ara-mkr/f405-flight-controller/README.md

# F405 Flight Controller

This is a flight controller I designed as a side project. It was fun and pretty challenging, and I'm planning to build a drone with it at some point!

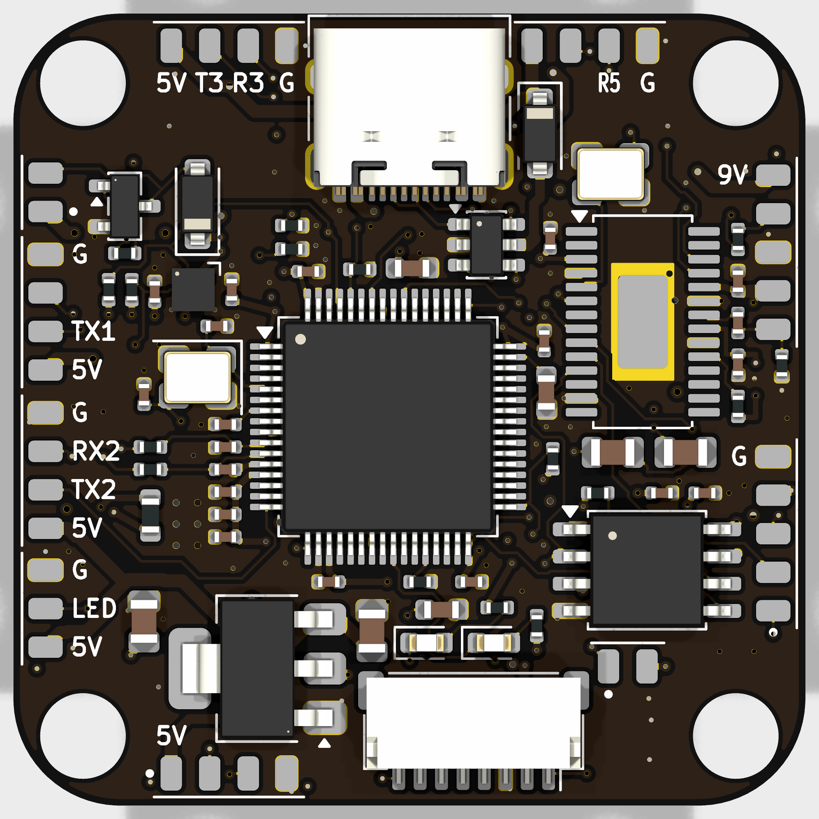
[picture p1: docs/img/hero_top.png]
Top view of the flight controller design


## The design

I did the schematic and layout in KiCad, and wrote some Python scripts to check the connections and spit out the manufacturing files.

It's built around an STM32F405. It reads the gyro and barometer and sends signals out to the ESCs. It also has its own power regulators and plugs for a receiver, GPS, and camera.

I haven't gotten it made or flown yet, so there's still a lot of building and testing to do. If you want to order one, here's [how I'd do it](HOW_TO_ORDER.md).

<table>
<tr>
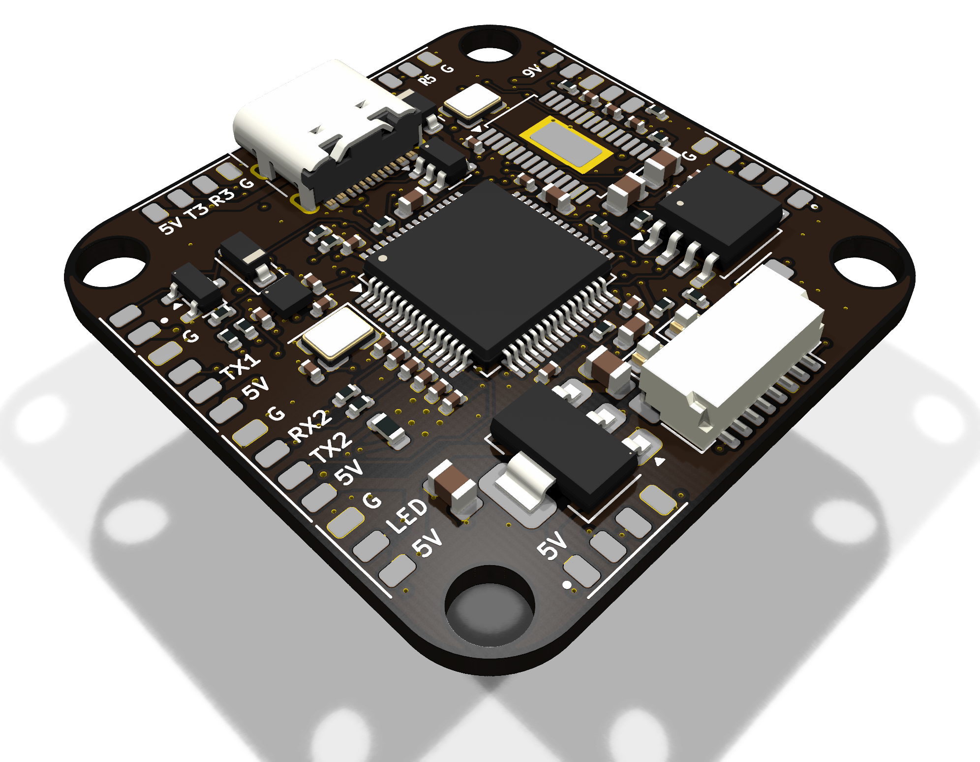
[picture p2: docs/img/iso.png]
Angled render of the board
<td width="50%"><br>Angled view</td>
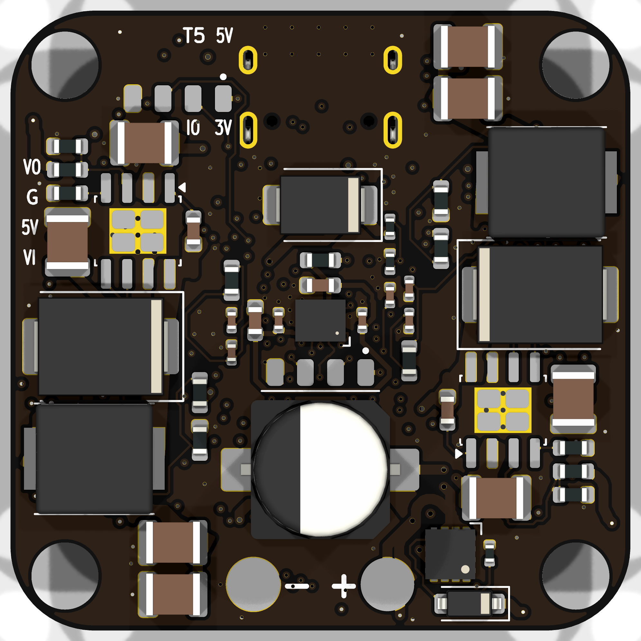
[picture p3: docs/img/bottom.png]
Bottom render of the board
<td width="50%"><br>Bottom view</td>
</tr>
<tr>
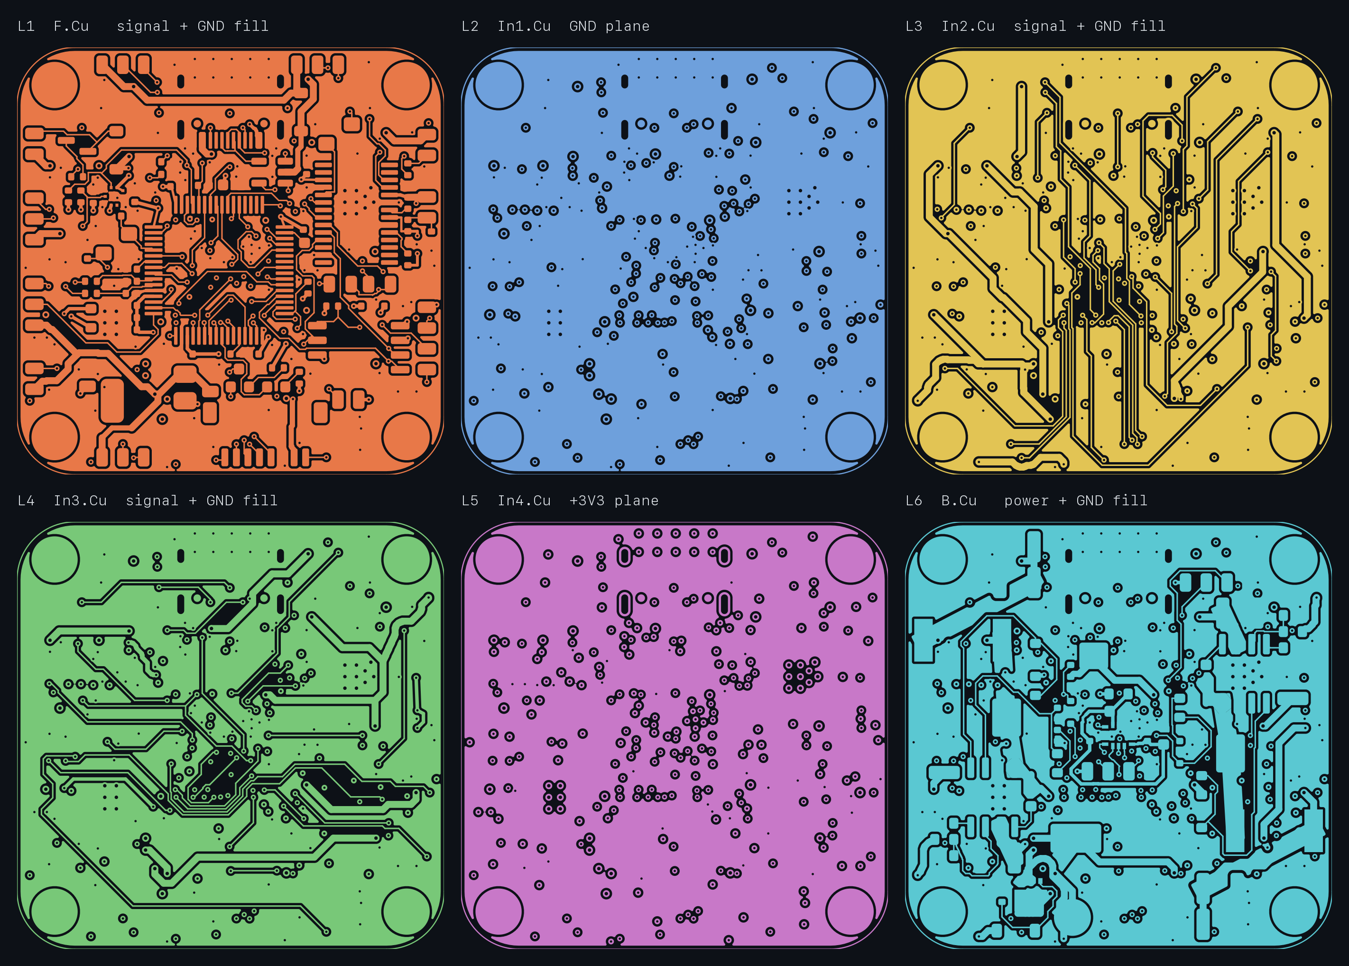
[picture p4: docs/img/copper.png]
The board's copper layers
<td><br>Copper layers</td>
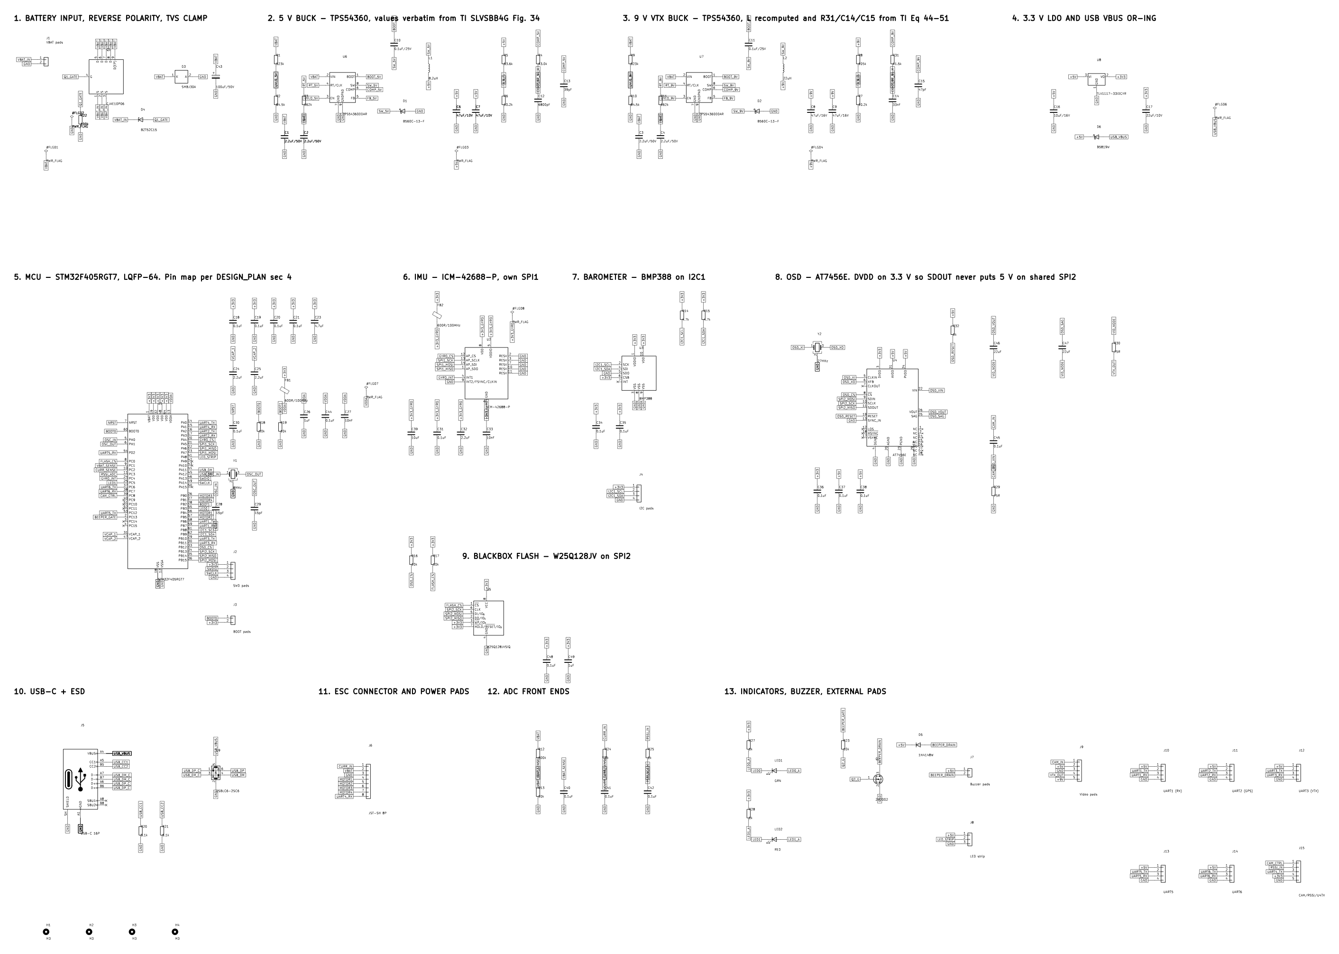
[picture p5: docs/img/schematic.png]
Circuit schematic
<td><br><a href="production/fc_f405_schematic.pdf">Schematic</a></td>
</tr>
</table>

Design files are in [hardware/](hardware/) and the manufacturing stuff is in [production/](production/).

Licensed under [CERN-OHL-P-2.0](LICENSE).
