ara-mkr/f405-flight-controller/docs/BOM.csv

refs | qty | value | mpn | lcsc | footprint | stock | type
C1,C2,C3,C4 | 4 | 2.2uF/50V | 1210B225K500NT | C1950 | C_1210_3225Metric | 11453 | Extended
C6,C7 | 2 | 47uF/10V | CS3225X7R476K100NRL | C5189825 | C_1210_3225Metric | 140829 | Extended
C8,C9 | 2 | 47uF/16V | CS3225X7R476K160NRL | C5440143 | C_1210_3225Metric | 93079 | Extended
C10,C11 | 2 | 0.1uF/25V | CC0603KRX7R9BB104 | C14663 | C_0603_1608Metric | 12618106 | Basic
C12 | 1 | 6800pF | 0402B682K500NT | C1542 | C_0402_1005Metric | 118595 | Preferred
C13 | 1 | 39pF | 0402CG390J500NT | C1563 | C_0402_1005Metric | 149222 | Extended
C14 | 1 | 33nF | 0402B333K500NT | C507072 | C_0402_1005Metric | 170655 | Extended
C15 | 1 | 47pF | 0402CG470J500NT | C1567 | C_0402_1005Metric | 243432 | Basic
C16 | 1 | 10uF/16V | GRM21BZ71C106KE15L | C162430 | C_0805_2012Metric | 114267 | Extended
C17 | 1 | 22uF/10V | CL21A226MAQNNNE | C45783 | C_0805_2012Metric | 1734789 | Basic
C18,C19,C20,C21,C30,C31,C34,C35,C36,C37,C38,C40,C41,C42,C44,C45,C48 | 17 | 0.1uF | CL05B104KO5NNNC | C1525 | C_0402_1005Metric | 16407331 | Basic
C23 | 1 | 4.7uF | GRM188Z71C475KE21D | C389010 | C_0603_1608Metric | 87761 | Extended
C24,C25,C32 | 3 | 2.2uF | GRM188R71A225KE15D | C86018 | C_0603_1608Metric | 459837 | Extended
C26,C49 | 2 | 1uF | GRM155R70J105KA12D | C88945 | C_0402_1005Metric | 451642 | Extended
C27,C33 | 2 | 10nF | CL05B103KB5NNNC | C15195 | C_0402_1005Metric | 2532413 | Basic
C28,C29 | 2 | 15pF | 0402CG150J500NT | C1548 | C_0402_1005Metric | 358497 | Basic
C39 | 1 | 10uF | CL10A106KP8NNNC | C19702 | C_0603_1608Metric | 5302559 | Basic
C43 | 1 | 100uF/50V | UUD1H101MNL1GS | C116241 | CP_Elec_8x10.5 | 174466 | Extended
C46,C47 | 2 | 22uF | CL21A226MAQNNNE | C45783 | C_0805_2012Metric | 1734789 | Basic
D1,D2 | 2 | B560C-13-F | B560C-13-F | C85100 | D_SMC | 212196 | Extended
D3 | 1 | SMBJ30A | SMBJ30A | C19077584 | D_SMB | 301717 | Preferred
D4 | 1 | BZT52C15 | BZT52C15 | C2932746 | D_SOD-123 | 273992 | Extended
D5 | 1 | 1N4148W | 1N4148W | C81598 | D_SOD-123 | 3538406 | Basic
D6 | 1 | B5819W | B5819W SL | C8598 | D_SOD-123 | 1059176 | Basic
FB1,FB2 | 2 | 600R/100MHz | GZ1608D601TF | C1002 | R_0603_1608Metric | 892564 | Basic
J1 | 1 | VBAT pads | Dia 3mm plated pads |  | SolderPad_3mm_x2
J2 | 1 | SWD pads | 1.0mm pads |  | SolderPad_1mm_x4
J3 | 1 | BOOT pads | 1.0mm pads |  | SolderPad_1mm_x2
J4 | 1 | I2C pads | ext compass |  | SolderPad_1mm_x4
J5 | 1 | USB-C 16P | TYPE-C 16PIN 2MD(073) | C2765186 | USB_C_Receptacle_HRO_TYPE-C-31-M-12 | 1171811 | Extended
J6 | 1 | JST-SH 8P | SM08B-SRSS-TB(LF)(SN) | C160407 | JST_SH_SM08B-SRSS-TB_1x08-1MP_P1.00mm_Horizontal | 267231 | Extended
J7 | 1 | Buzzer pads |  |  | SolderPad_1mm_x2
J8 | 1 | LED strip |  |  | SolderPad_1mm_x3
J9 | 1 | Video pads |  |  | SolderPad_1mm_x6
J10 | 1 | UART1 (RX) |  |  | SolderPad_1mm_x4
J11 | 1 | UART2 (GPS) |  |  | SolderPad_1mm_x4
J12 | 1 | UART3 (VTX) |  |  | SolderPad_1mm_x4
J13 | 1 | UART5 |  |  | SolderPad_1mm_x4
J14 | 1 | UART6 |  |  | SolderPad_1mm_x4
J15 | 1 | CAM/RSSI/U4TX |  |  | SolderPad_1mm_x5
L1 | 1 | 8.2uH | SMMS0630-8R2M | C128691 | L_SMMS0630_7.1x6.6mm | 12694 | Extended
L2 | 1 | 22uH | SMMS0630-220M | C128694 | L_SMMS0630_7.1x6.6mm | 192695 | Extended
LED1 | 1 | GRN | XL-1608UGC-04 | C965804 | LED_0603_1608Metric | 6367682 | Extended
LED2 | 1 | RED | XL-1608SURC-06 | C965799 | LED_0603_1608Metric | 5989534 | Extended
Q1 | 1 | CJAE10P06 | CJAE10P06 | C2943210 | PDFNWB-8L_3x3mm_DrainPad | 18156 | Extended
Q2 | 1 | 2N7002 | 2N7002K | C414015 | SOT-23 | 3064287 | Extended
R1,R9 | 2 | 523k | FRC0603F5233TS | C5126197 | R_0603_1608Metric | 49470 | Extended
R2,R10 | 2 | 84.5k | FRC0603F8452TS | C2998081 | R_0603_1608Metric | 49863 | Extended
R3,R11 | 2 | 162k | FRC0603F1623TS | C2998114 | R_0603_1608Metric | 477208 | Extended
R4 | 1 | 13.0k | 0603WAF1302T5E | C22797 | R_0603_1608Metric | 388035 | Basic
R5 | 1 | 53.6k | FRC0603F5362TS | C2930115 | R_0603_1608Metric | 90035 | Extended
R6,R7 | 2 | 10.2k | FRC0603F1022TS | C2933125 | R_0603_1608Metric | 776375 | Extended
R8 | 1 | 105k | FRC0402F1053TS | C2933067 | R_0603_1608Metric | 282708 | Extended
R12,R22 | 2 | 100k | 0402WGF1003TCE | C25741 | R_0402_1005Metric | 1535859 | Basic
R13,R16,R17,R18,R19,R23 | 6 | 10k | 0402WGF1002TCE | C25744 | R_0402_1005Metric | 1256270 | Basic
R14,R15 | 2 | 4.7k | 0402WGF4701TCE | C25900 | R_0402_1005Metric | 3285378 | Basic
R20,R21 | 2 | 5.1k | 0402WGF5101TCE | C25905 | R_0402_1005Metric | 2237664 | Basic
R24,R25,R27,R28,R32 | 5 | 1k | 0402WGF1001TCE | C11702 | R_0402_1005Metric | 2610919 | Basic
R29,R30 | 2 | 75R | 0402WGF750JTCE | C25133 | R_0402_1005Metric | 306701 | Preferred
R31 | 1 | 11.5k | 0603WAF1152T5E | C25949 | R_0603_1608Metric | 173026 | Extended
U1 | 1 | STM32F405RGT7 | STM32F405RGT7 | C1337199 | LQFP-64_10x10mm_P0.5mm | 610 | Extended
U2 | 1 | ICM-42688-P | ICM-42688-P | C1850418 | TDK_LGA-14_2.5x3.0mm | 3920 | Extended
U3 | 1 | BMP388 | BMP388 | C779278 | Bosch_LGA-10_2.0x2.0mm | 15008 | Extended
U4 | 1 | AT7456E | AT7456E | C82351 | HTSSOP-28-1EP_4.4x9.7mm_P0.65mm_EP2.85x5.4mm | 33930 | Extended
U5 | 1 | W25Q128JVSIQ | W25Q128JVSIQ | C97521 | SOIC-8_5.3x5.3mm_P1.27mm | 94978 | Basic
U6,U7 | 2 | TPS54360DDAR | TPS54360DDAR | C44377 | SOIC-8-1EP_3.9x4.9mm_P1.27mm_EP2.95x4.9mm_Mask2.71x3.4mm | 30171 | Extended
U8 | 1 | TLV1117-33IDCYR | TLV1117-33IDCYR | C37359 | SOT-223-3_TabPin2 | 14146 | Extended
U9 | 1 | USBLC6-2SC6 | USBLC6-2SC6 | C2687116 | SOT-23-6 | 150192 | Extended
Y1 | 1 | 8MHz | TAXM8M4RDBCCT2T | C400090 | Crystal_SMD_3225-4Pin_3.2x2.5mm | 182379 | Extended
Y2 | 1 | 27MHz | XL2EL89CMI-111YLC-27M | C19711726 | Crystal_SMD_3225-4Pin_3.2x2.5mm | 18258 | Extended
