ara-mkr/f405-flight-controller/production/fc_f405_schematic.pdf

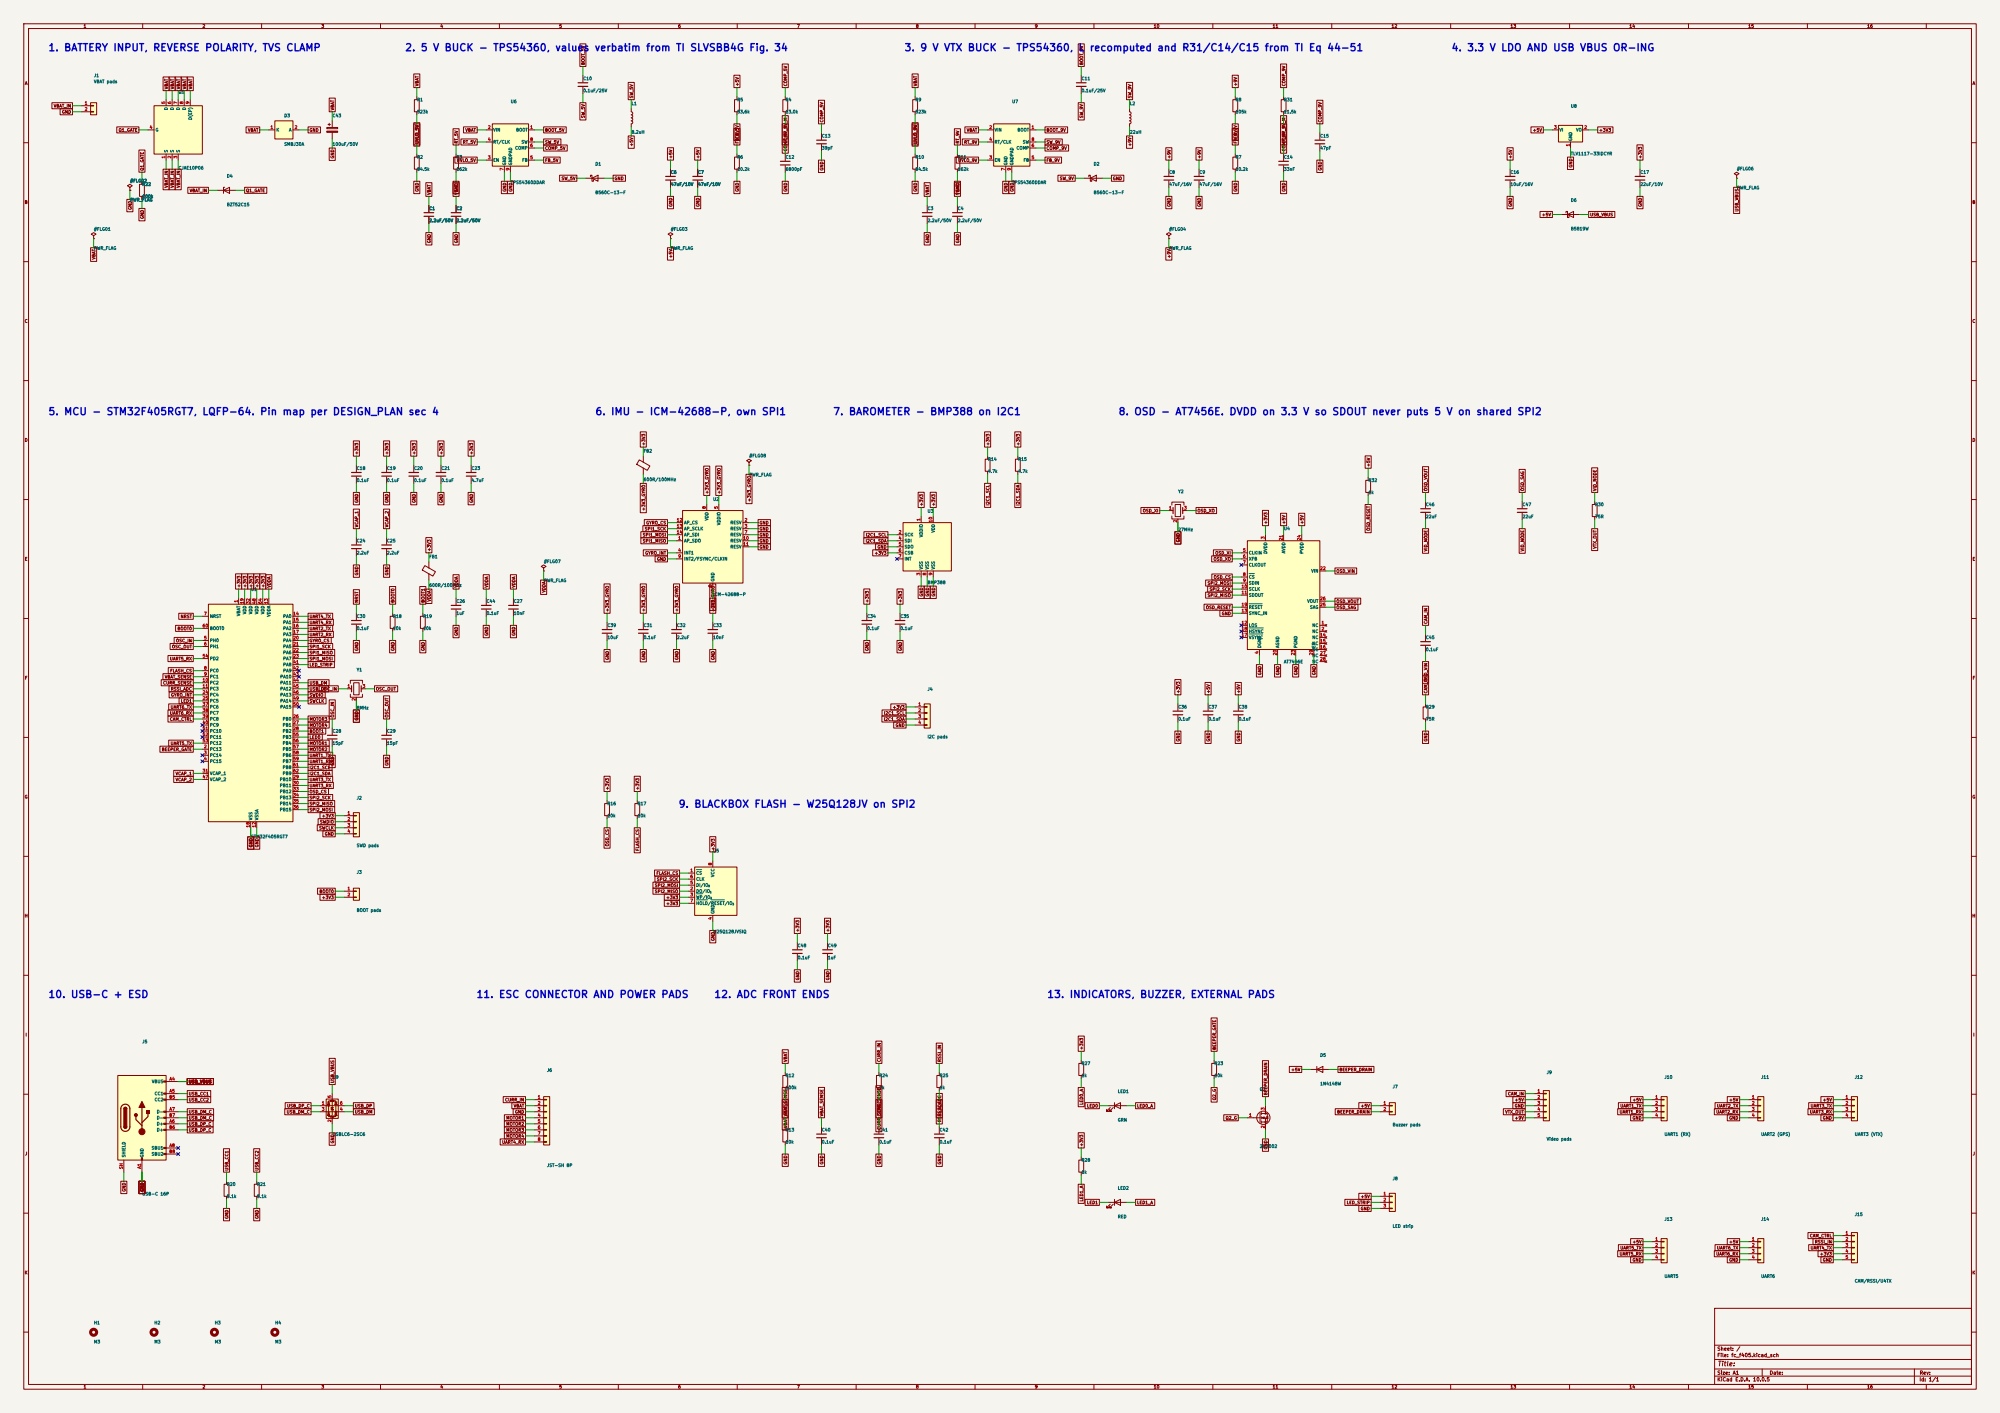
[picture p6: page 1]

1. BATTERY INPUT, REVERSE POLARITY, TVS CLAMP

4. 3.3 V LDO AND USB VBUS OR-ING

5. MCU - STM32F405RGT7, LQFP-64. Pin map per DESIGN_PLAN sec 4

4 DI/IO0 5 CLK 6 HOLD/RESET/IO3 7 VCC

13. INDICATORS, BUZZER, EXTERNAL PADS

Size: A1 | Rev:
KiCad E.D.A. 10.0.5 | Id: 1/1
