ara-mkr/f405-flight-controller/production/fc_f405_assembly_bottom.pdf

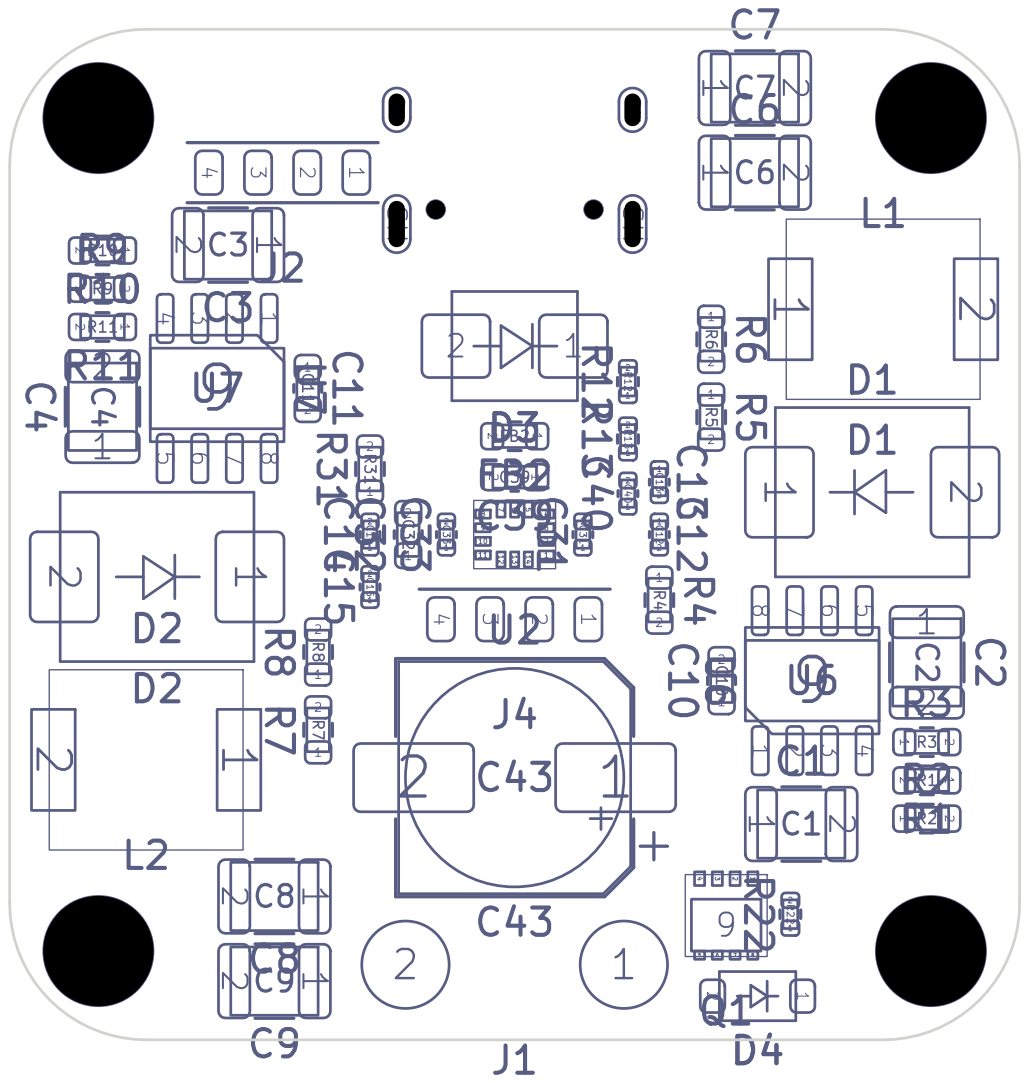
[picture p7: page 1]

D1
