ara-mkr/f405-flight-controller/production/fc_f405_assembly_top.pdf

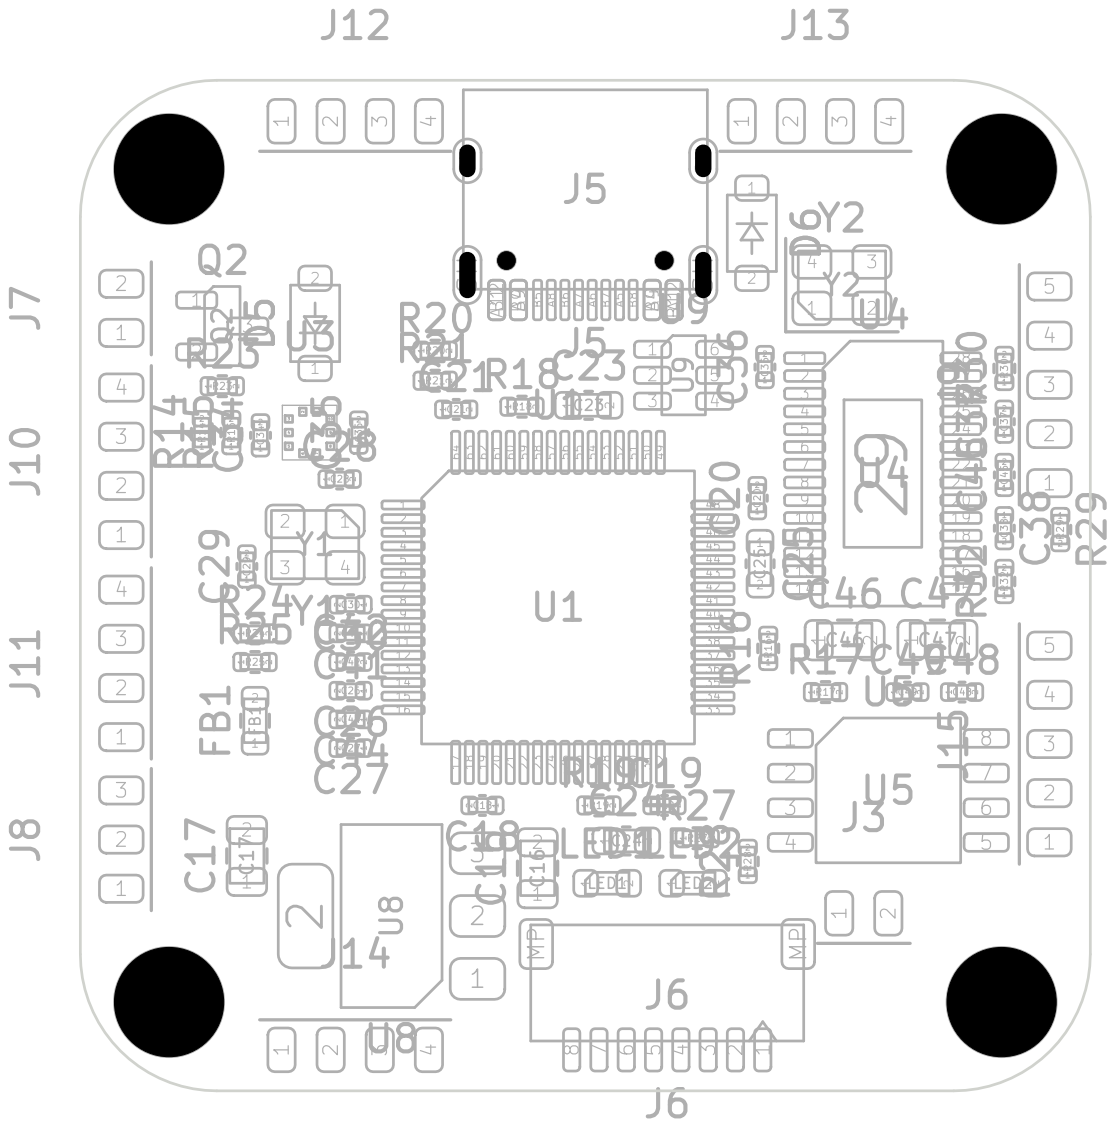
[picture p8: page 1]
