ara-mkr/f405-flight-controller/(list of files, drawings)

Other design files:
hardware/fc_f405.dsn
hardware/fc_f405_raw.dsn
