ara-mkr/f405-flight-controller/hardware/fc_f405.kicad_pcb

## KiCad design hardware/fc_f405.kicad_pcb (2026-10-18)

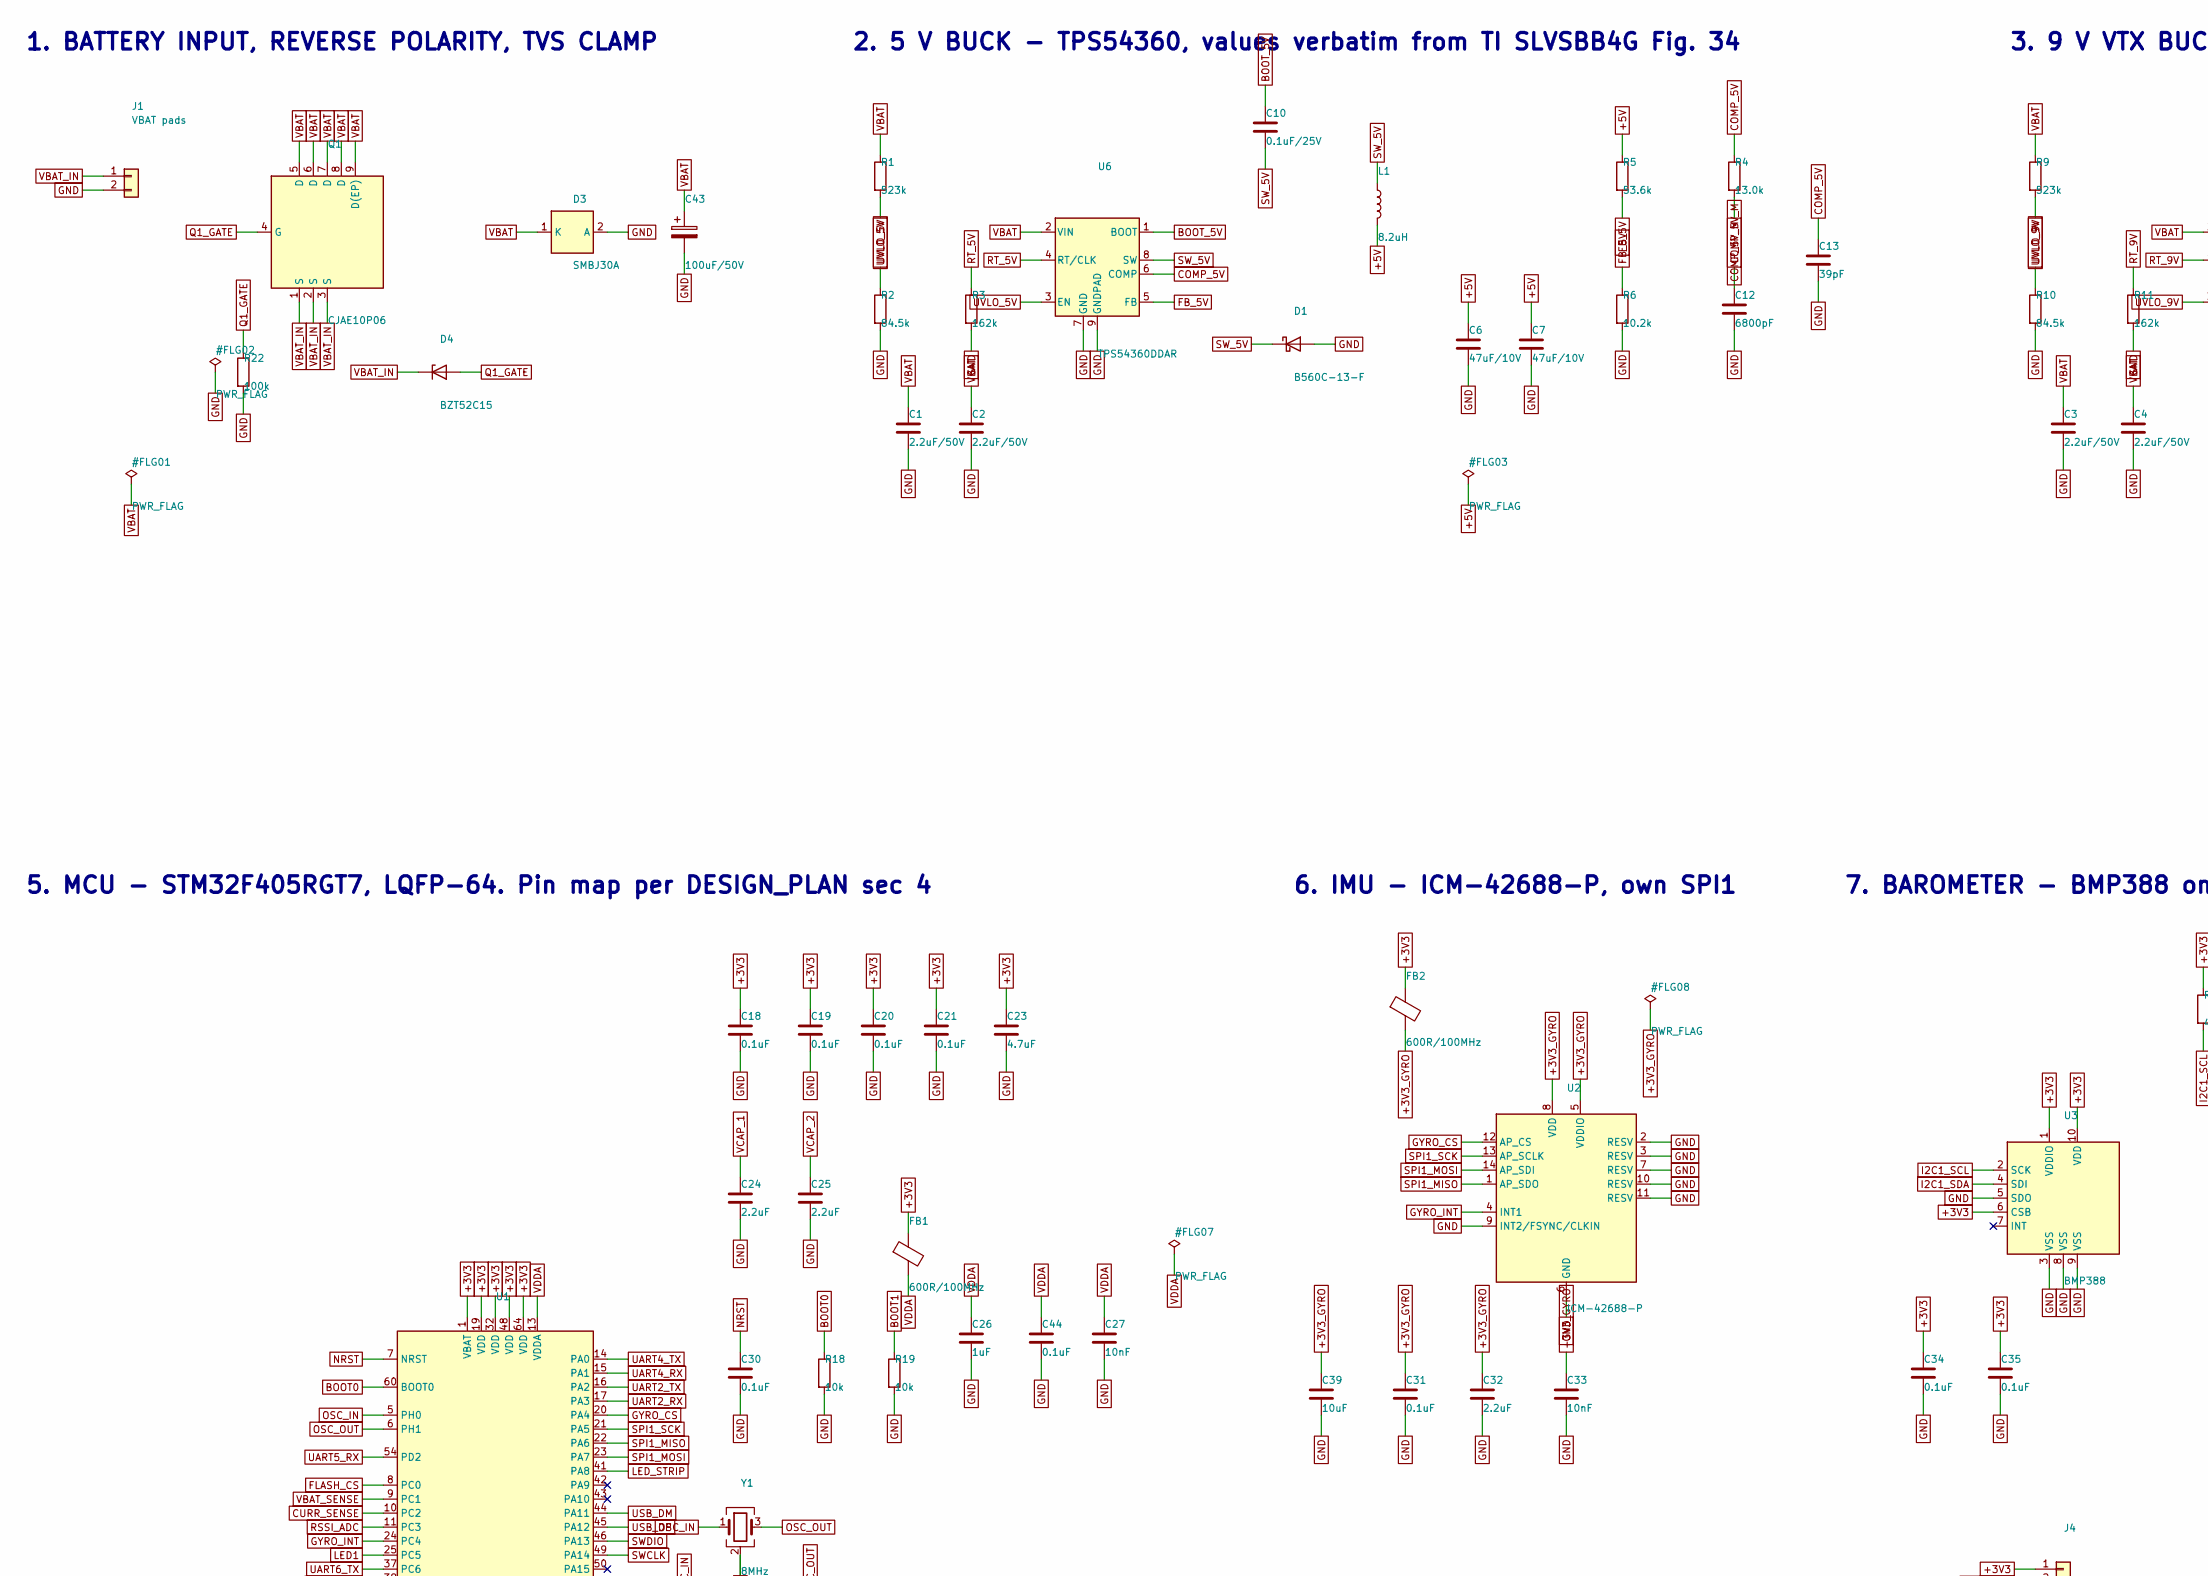
[picture p9: schematic fc_f405.kicad_sch, part in row 1, column 1]

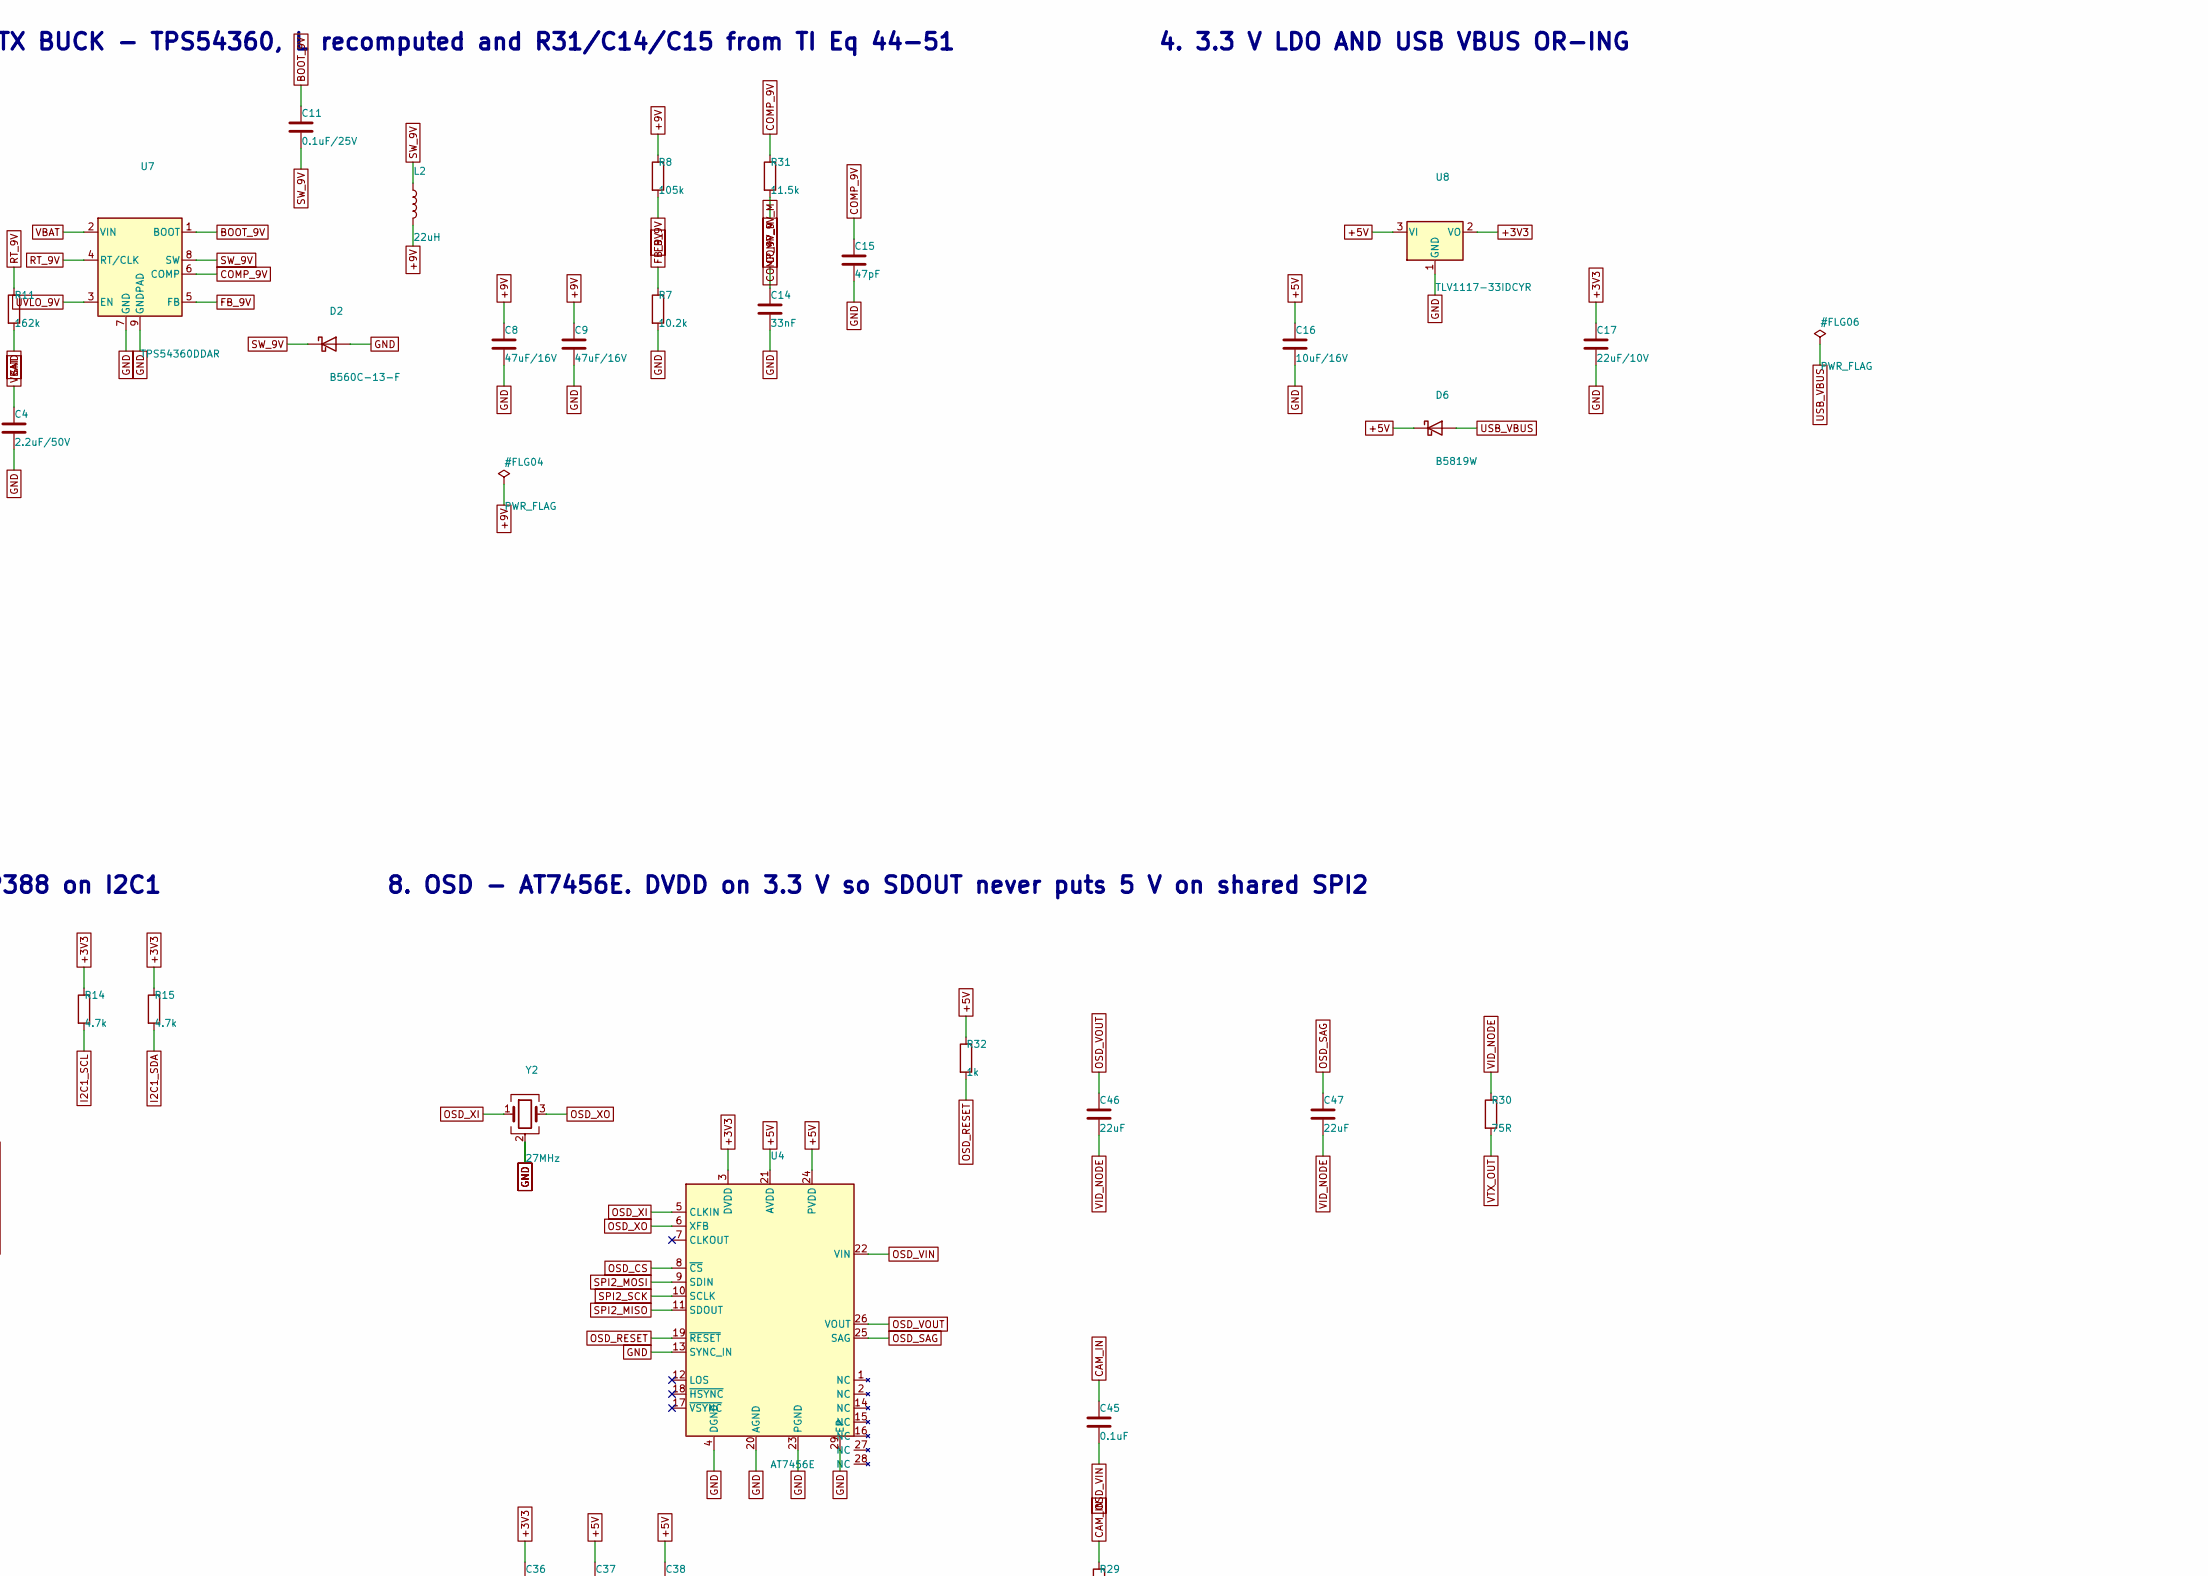
[picture p10: schematic fc_f405.kicad_sch, part in row 1, column 2]

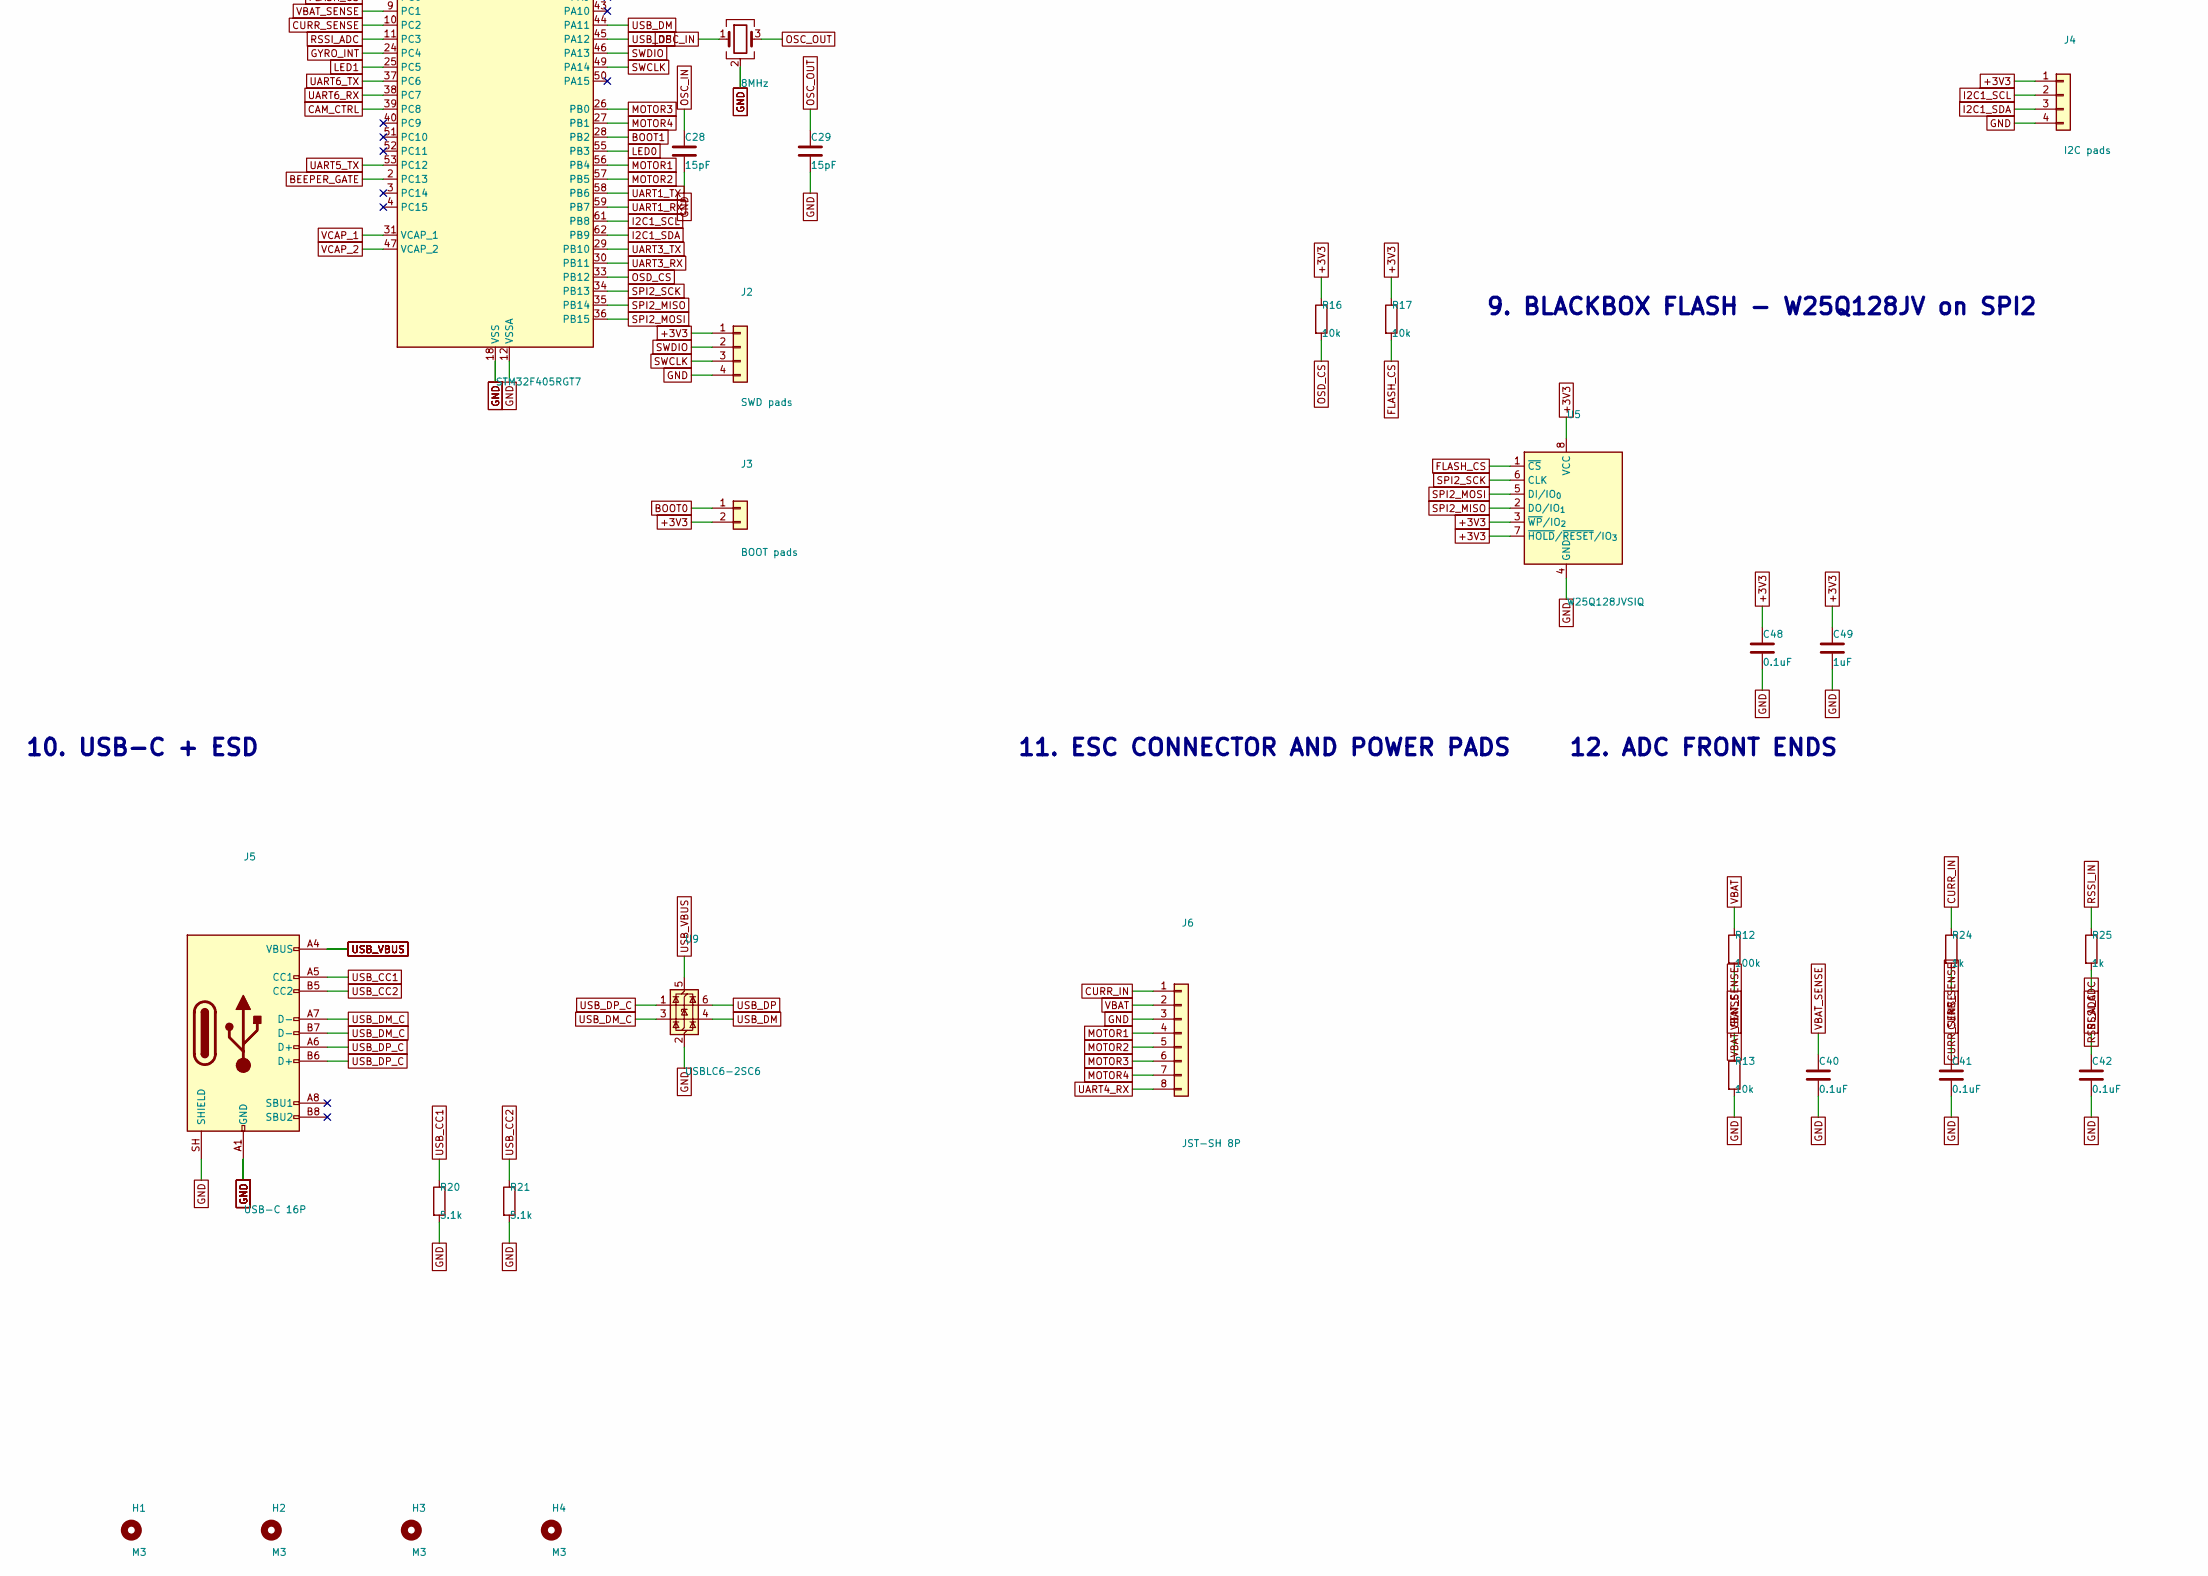
[picture p11: schematic fc_f405.kicad_sch, part in row 2, column 1]

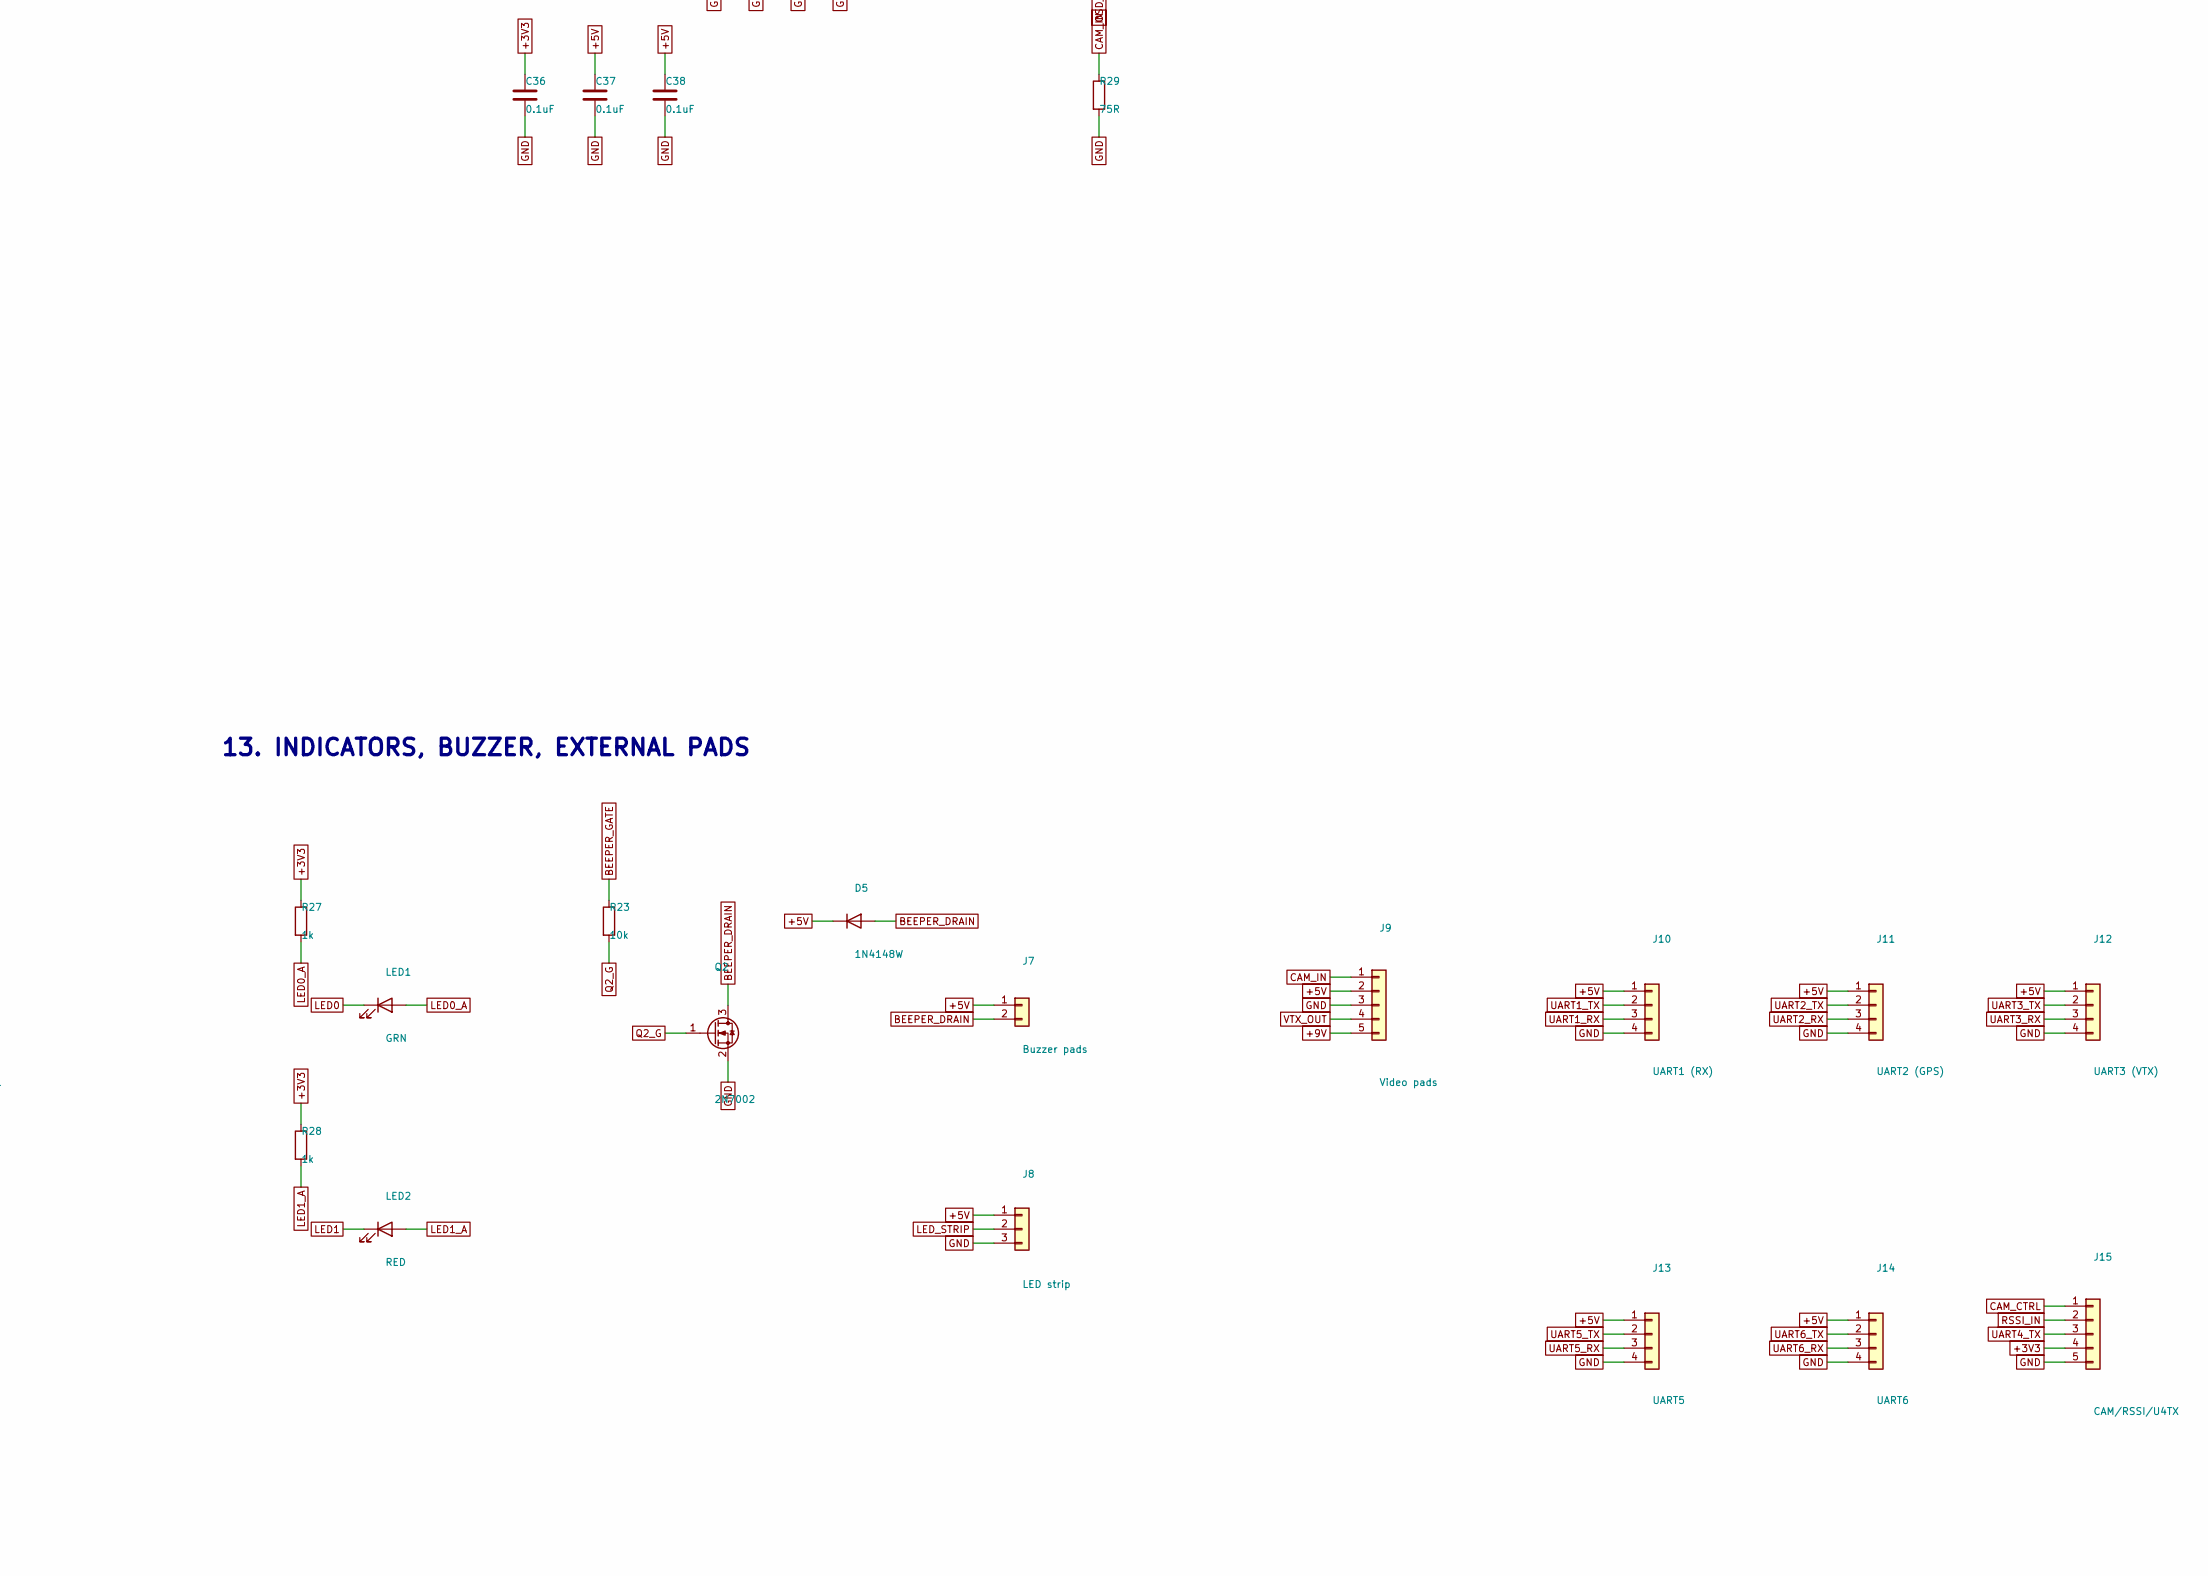
[picture p12: schematic fc_f405.kicad_sch, part in row 2, column 2]

Parts:
C1, C2, C3, C4: 2.2uF/50V; C_1210_3225Metric; MPN 1210B225K500NT; LCSC C1950
C6, C7: 47uF/10V; C_1210_3225Metric; MPN CS3225X7R476K100NRL; LCSC C5189825
C8, C9: 47uF/16V; C_1210_3225Metric; MPN CS3225X7R476K160NRL; LCSC C5440143
C10, C11: 0.1uF/25V; C_0603_1608Metric; MPN CC0603KRX7R9BB104; LCSC C14663
C12: 6800pF; C_0402_1005Metric; MPN 0402B682K500NT; LCSC C1542
C13: 39pF; C_0402_1005Metric; MPN 0402CG390J500NT; LCSC C1563
C14: 33nF; C_0402_1005Metric; MPN 0402B333K500NT; LCSC C507072
C15: 47pF; C_0402_1005Metric; MPN 0402CG470J500NT; LCSC C1567
C16: 10uF/16V; C_0805_2012Metric; MPN GRM21BZ71C106KE15L; LCSC C162430
C17: 22uF/10V; C_0805_2012Metric; MPN CL21A226MAQNNNE; LCSC C45783
C18, C19, C20, C21, C30, C31, C34, C35, C36, C37, C38, C40, C41, C42, C44, C45, C48: 0.1uF; C_0402_1005Metric; MPN CL05B104KO5NNNC; LCSC C1525
C23: 4.7uF; C_0603_1608Metric; MPN GRM188Z71C475KE21D; LCSC C389010
C24, C25, C32: 2.2uF; C_0603_1608Metric; MPN GRM188R71A225KE15D; LCSC C86018
C26, C49: 1uF; C_0402_1005Metric; MPN GRM155R70J105KA12D; LCSC C88945
C27, C33: 10nF; C_0402_1005Metric; MPN CL05B103KB5NNNC; LCSC C15195
C28, C29: 15pF; C_0402_1005Metric; MPN 0402CG150J500NT; LCSC C1548
C39: 10uF; C_0603_1608Metric; MPN CL10A106KP8NNNC; LCSC C19702
C43: 100uF/50V; CP_Elec_8x10.5; MPN UUD1H101MNL1GS; LCSC C116241
C46, C47: 22uF; C_0805_2012Metric; MPN CL21A226MAQNNNE; LCSC C45783
D1, D2: B560C-13-F; D_SMC; MPN B560C-13-F; LCSC C85100
D3: SMBJ30A; D_SMB; MPN SMBJ30A; LCSC C19077584
D4: BZT52C15; D_SOD-123; MPN BZT52C15; LCSC C2932746
D5: 1N4148W; D_SOD-123; MPN 1N4148W; LCSC C81598
D6: B5819W; D_SOD-123; MPN B5819W SL; LCSC C8598
FB1, FB2: 600R/100MHz; R_0603_1608Metric; MPN GZ1608D601TF; LCSC C1002
H1, H2, H3, H4: M3; MountingHole_4.0mm
J1: VBAT pads; SolderPad_3mm_x2; MPN Dia 3mm plated pads
J2: SWD pads; SolderPad_1mm_x4; MPN 1.0mm pads
J3: BOOT pads; SolderPad_1mm_x2; MPN 1.0mm pads
J4: I2C pads; SolderPad_1mm_x4; MPN ext compass
J5: USB-C 16P; USB_C_Receptacle_HRO_TYPE-C-31-M-12; MPN TYPE-C 16PIN 2MD(073); LCSC C2765186
J6: JST-SH 8P; JST_SH_SM08B-SRSS-TB_1x08-1MP_P1.00mm_Horizontal; MPN SM08B-SRSS-TB(LF)(SN); LCSC C160407
J7: Buzzer pads; SolderPad_1mm_x2
J8: LED strip; SolderPad_1mm_x3
J9: Video pads; SolderPad_1mm_x5
J10: UART1 (RX); SolderPad_1mm_x4
J11: UART2 (GPS); SolderPad_1mm_x4
J12: UART3 (VTX); SolderPad_1mm_x4
J13: UART5; SolderPad_1mm_x4
J14: UART6; SolderPad_1mm_x4
J15: CAM/RSSI/U4TX; SolderPad_1mm_x5
L1: 8.2uH; L_SMMS0630_7.1x6.6mm; MPN SMMS0630-8R2M; LCSC C128691
L2: 22uH; L_SMMS0630_7.1x6.6mm; MPN SMMS0630-220M; LCSC C128694
LED1: GRN; LED_0603_1608Metric; MPN XL-1608UGC-04; LCSC C965804
LED2: RED; LED_0603_1608Metric; MPN XL-1608SURC-06; LCSC C965799
Q1: CJAE10P06; PDFNWB-8L_3x3mm_DrainPad; MPN CJAE10P06; LCSC C2943210
Q2: 2N7002; SOT-23; MPN 2N7002K; LCSC C414015
R1, R9: 523k; R_0603_1608Metric; MPN FRC0603F5233TS; LCSC C5126197
R2, R10: 84.5k; R_0603_1608Metric; MPN FRC0603F8452TS; LCSC C2998081
R3, R11: 162k; R_0603_1608Metric; MPN FRC0603F1623TS; LCSC C2998114
R4: 13.0k; R_0603_1608Metric; MPN 0603WAF1302T5E; LCSC C22797
R5: 53.6k; R_0603_1608Metric; MPN FRC0603F5362TS; LCSC C2930115
R6, R7: 10.2k; R_0603_1608Metric; MPN FRC0603F1022TS; LCSC C2933125
R8: 105k; R_0603_1608Metric; MPN FRC0402F1053TS; LCSC C2933067
R12, R22: 100k; R_0402_1005Metric; MPN 0402WGF1003TCE; LCSC C25741
R13, R16, R17, R18, R19, R23: 10k; R_0402_1005Metric; MPN 0402WGF1002TCE; LCSC C25744
R14, R15: 4.7k; R_0402_1005Metric; MPN 0402WGF4701TCE; LCSC C25900
R20, R21: 5.1k; R_0402_1005Metric; MPN 0402WGF5101TCE; LCSC C25905
R24, R25, R27, R28, R32: 1k; R_0402_1005Metric; MPN 0402WGF1001TCE; LCSC C11702
R29, R30: 75R; R_0402_1005Metric; MPN 0402WGF750JTCE; LCSC C25133
R31: 11.5k; R_0603_1608Metric; MPN 0603WAF1152T5E; LCSC C25949
U1: STM32F405RGT7; LQFP-64_10x10mm_P0.5mm; MPN STM32F405RGT7; LCSC C1337199
U2: ICM-42688-P; TDK_LGA-14_2.5x3.0mm; MPN ICM-42688-P; LCSC C1850418
U3: BMP388; Bosch_LGA-10_2.0x2.0mm; MPN BMP388; LCSC C779278
U4: AT7456E; HTSSOP-28-1EP_4.4x9.7mm_P0.65mm_EP2.85x5.4mm; MPN AT7456E; LCSC C82351
U5: W25Q128JVSIQ; SOIC-8_5.3x5.3mm_P1.27mm; MPN W25Q128JVSIQ; LCSC C97521
U6, U7: TPS54360DDAR; SOIC-8-1EP_3.9x4.9mm_P1.27mm_EP2.95x4.9mm_Mask2.71x3.4mm; MPN TPS54360DDAR; LCSC C44377
U8: TLV1117-33IDCYR; SOT-223-3_TabPin2; MPN TLV1117-33IDCYR; LCSC C37359
U9: USBLC6-2SC6; SOT-23-6; MPN USBLC6-2SC6; LCSC C2687116
Y1: 8MHz; Crystal_SMD_3225-4Pin_3.2x2.5mm; MPN TAXM8M4RDBCCT2T; LCSC C400090
Y2: 27MHz; Crystal_SMD_3225-4Pin_3.2x2.5mm; MPN XL2EL89CMI-111YLC-27M; LCSC C19711726

Connections:
+3V3: C17.1, C18.1, C19.1, C20.1, C21.1, C23.1, C34.1, C35.1, C36.1, C48.1, C49.1, FB1.1, FB2.1, J2.1, J3.2, J4.1, J15.4, R14.1, R15.1, R16.1, R17.1, R27.1, R28.1, U1.1 (VBAT), U1.19 (VDD), U1.32 (VDD), U1.48 (VDD), U1.64 (VDD), U3.1 (VDDIO), U3.6 (CSB), U3.10 (VDD), U4.3 (DVDD), U5.3 (~WP/IO_{2}), U5.7 (~HOLD/~RESET/IO_{3}), U5.8 (VCC), U8.2 (VO)
+3V3_GYRO: C31.1, C32.1, C33.1, C39.1, FB2.2, U2.5 (VDDIO), U2.8 (VDD)
+5V: C6.1, C7.1, C16.1, C37.1, C38.1, D5.1 (K), D6.1 (K), J7.1, J8.1, J9.2, J10.1, J11.1, J12.1, J13.1, J14.1, L1.2, R5.1, R32.1, U4.21 (AVDD), U4.24 (PVDD), U8.3 (VI)
+9V: C8.1, C9.1, J9.5, L2.2, R8.1
BEEPER_DRAIN: D5.2 (A), J7.2, Q2.3 (D)
BEEPER_GATE: R23.1, U1.2 (PC13)
BOOT0: J3.1, R18.1, U1.60 (BOOT0)
BOOT1: R19.1, U1.28 (PB2)
BOOT_5V: C10.1, U6.1 (BOOT)
BOOT_9V: C11.1, U7.1 (BOOT)
CAM_CTRL: J15.1, U1.39 (PC8)
CAM_IN: C45.1, J9.1, R29.1
COMP_5V: C13.1, R4.1, U6.6 (COMP)
COMP_5V_M: C12.1, R4.2
COMP_9V: C15.1, R31.1, U7.6 (COMP)
COMP_9V_M: C14.1, R31.2
CURR_IN: J6.1, R24.1
CURR_SENSE: C41.1, R24.2, U1.10 (PC2)
FB_5V: R5.2, R6.1, U6.5 (FB)
FB_9V: R7.1, R8.2, U7.5 (FB)
FLASH_CS: R17.2, U1.8 (PC0), U5.1 (~CS)
GND: C1.2, C2.2, C3.2, C4.2, C6.2, C7.2, C8.2, C9.2, C12.2, C13.2, C14.2, C15.2, C16.2, C17.2, C18.2, C19.2, C20.2, C21.2, C23.2, C24.2, C25.2, C26.2, C27.2, C28.2, C29.2, C30.2, C31.2, C32.2, C33.2, C34.2, C35.2, C36.2, C37.2, C38.2, C39.2, C40.2, C41.2, C42.2, C43.2, C44.2, C48.2, C49.2, D1.2 (A), D2.2 (A), D3.2 (A), J1.2, J2.4, J4.4, J5.A1 (GND), J5.A12 (GND), J5.B1 (GND), J5.B12 (GND), J5.SH (SHIELD), J6.3, J8.3, J9.3, J10.4, J11.4, J12.4, J13.4, J14.4, J15.5, Q2.2 (S), R2.2, R3.2, R6.2, R7.2, R10.2, R11.2, R13.2, R18.2, R19.2, R20.2, R21.2, R22.2, R29.2, U1.12 (VSSA), U1.18 (VSS), U1.63 (VSS), U2.2 (RESV), U2.3 (RESV), U2.6 (GND), U2.7 (RESV), U2.9 (INT2/FSYNC/CLKIN), U2.10 (RESV), U2.11 (RESV), U3.3 (VSS), U3.5 (SDO), U3.8 (VSS), U3.9 (VSS), U4.4 (DGND), U4.13 (SYNC_IN), U4.20 (AGND), U4.23 (PGND), U4.29 (EP), U5.4 (GND), U6.7 (GND), U6.9 (GNDPAD), U7.7 (GND), U7.9 (GNDPAD), U8.1 (GND), U9.2 (GND), Y1.2 (G), Y1.4 (G), Y2.2 (G), Y2.4 (G)
GYRO_CS: U1.20 (PA4), U2.12 (AP_CS)
GYRO_INT: U1.24 (PC4), U2.4 (INT1)
I2C1_SCL: J4.2, R14.2, U1.61 (PB8), U3.2 (SCK)
I2C1_SDA: J4.3, R15.2, U1.62 (PB9), U3.4 (SDI)
LED0: LED1.1 (K), U1.55 (PB3)
LED0_A: LED1.2 (A), R27.2
LED1: LED2.1 (K), U1.25 (PC5)
LED1_A: LED2.2 (A), R28.2
LED_STRIP: J8.2, U1.41 (PA8)
MOTOR1: J6.4, U1.56 (PB4)
MOTOR2: J6.5, U1.57 (PB5)
MOTOR3: J6.6, U1.26 (PB0)
MOTOR4: J6.7, U1.27 (PB1)
NRST: C30.1, U1.7 (NRST)
OSC_IN: C28.1, U1.5 (PH0), Y1.1
OSC_OUT: C29.1, U1.6 (PH1), Y1.3
OSD_CS: R16.2, U1.33 (PB12), U4.8 (~CS)
OSD_RESET: R32.2, U4.19 (~RESET)
OSD_SAG: C47.1, U4.25 (SAG)
OSD_VIN: C45.2, U4.22 (VIN)
OSD_VOUT: C46.1, U4.26 (VOUT)
OSD_XI: U4.5 (CLKIN), Y2.1
OSD_XO: U4.6 (XFB), Y2.3
Q1_GATE: D4.2 (A), Q1.4 (G), R22.1
Q2_G: Q2.1 (G), R23.2
RSSI_ADC: C42.1, R25.2, U1.11 (PC3)
RSSI_IN: J15.2, R25.1
RT_5V: R3.1, U6.4 (RT/CLK)
RT_9V: R11.1, U7.4 (RT/CLK)
SPI1_MISO: U1.22 (PA6), U2.1 (AP_SDO)
SPI1_MOSI: U1.23 (PA7), U2.14 (AP_SDI)
SPI1_SCK: U1.21 (PA5), U2.13 (AP_SCLK)
SPI2_MISO: U1.35 (PB14), U4.11 (SDOUT), U5.2 (DO/IO_{1})
SPI2_MOSI: U1.36 (PB15), U4.9 (SDIN), U5.5 (DI/IO_{0})
SPI2_SCK: U1.34 (PB13), U4.10 (SCLK), U5.6 (CLK)
SWCLK: J2.3, U1.49 (PA14)
SWDIO: J2.2, U1.46 (PA13)
SW_5V: C10.2, D1.1 (K), L1.1, U6.8 (SW)
SW_9V: C11.2, D2.1 (K), L2.1, U7.8 (SW)
UART1_RX: J10.3, U1.59 (PB7)
UART1_TX: J10.2, U1.58 (PB6)
UART2_RX: J11.3, U1.17 (PA3)
UART2_TX: J11.2, U1.16 (PA2)
UART3_RX: J12.3, U1.30 (PB11)
UART3_TX: J12.2, U1.29 (PB10)
UART4_RX: J6.8, U1.15 (PA1)
UART4_TX: J15.3, U1.14 (PA0)
UART5_RX: J13.3, U1.54 (PD2)
UART5_TX: J13.2, U1.53 (PC12)
UART6_RX: J14.3, U1.38 (PC7)
UART6_TX: J14.2, U1.37 (PC6)
USB_CC1: J5.A5 (CC1), R20.1
USB_CC2: J5.B5 (CC2), R21.1
USB_DM: U1.44 (PA11), U9.4 (I/O2)
USB_DM_C: J5.A7 (D-), J5.B7 (D-), U9.3 (I/O2)
USB_DP: U1.45 (PA12), U9.6 (I/O1)
USB_DP_C: J5.A6 (D+), J5.B6 (D+), U9.1 (I/O1)
USB_VBUS: D6.2 (A), J5.A4 (VBUS), J5.A9 (VBUS), J5.B4 (VBUS), J5.B9 (VBUS), U9.5 (VBUS)
UVLO_5V: R1.2, R2.1, U6.3 (EN)
UVLO_9V: R9.2, R10.1, U7.3 (EN)
VBAT: C1.1, C2.1, C3.1, C4.1, C43.1, D3.1 (K), J6.2, Q1.5 (D), Q1.6 (D), Q1.7 (D), Q1.8 (D), Q1.9 (D(EP)), R1.1, R9.1, R12.1, U6.2 (VIN), U7.2 (VIN)
VBAT_IN: D4.1 (K), J1.1, Q1.1 (S), Q1.2 (S), Q1.3 (S)
VBAT_SENSE: C40.1, R12.2, R13.1, U1.9 (PC1)
VCAP_1: C24.1, U1.31 (VCAP_1)
VCAP_2: C25.1, U1.47 (VCAP_2)
VDDA: C26.1, C27.1, C44.1, FB1.2, U1.13 (VDDA)
VID_NODE: C46.2, C47.2, R30.1
VTX_OUT: J9.4, R30.2

Notes on the sheet:
1. BATTERY INPUT, REVERSE POLARITY, TVS CLAMP
2. 5 V BUCK - TPS54360, values verbatim from TI SLVSBB4G Fig. 34
3. 9 V VTX BUCK - TPS54360, L recomputed and R31/C14/C15 from TI Eq 44-51
4. 3.3 V LDO AND USB VBUS OR-ING
5. MCU - STM32F405RGT7, LQFP-64. Pin map per DESIGN_PLAN sec 4
6. IMU - ICM-42688-P, own SPI1
7. BAROMETER - BMP388 on I2C1
8. OSD - AT7456E. DVDD on 3.3 V so SDOUT never puts 5 V on shared SPI2
9. BLACKBOX FLASH - W25Q128JV on SPI2
10. USB-C + ESD
11. ESC CONNECTOR AND POWER PADS
12. ADC FRONT ENDS
13. INDICATORS, BUZZER, EXTERNAL PADS

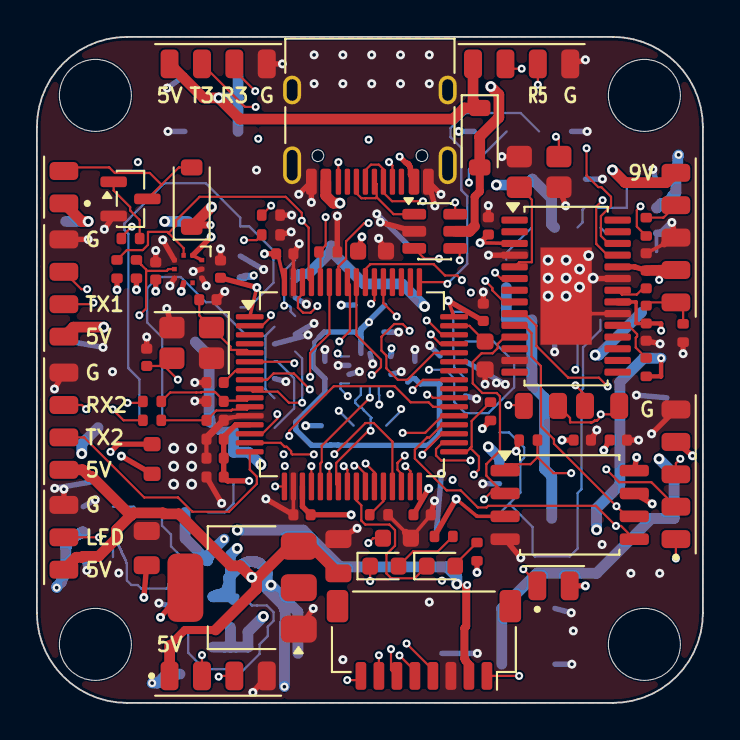
[picture p13: board fc_f405.kicad_pcb from above]

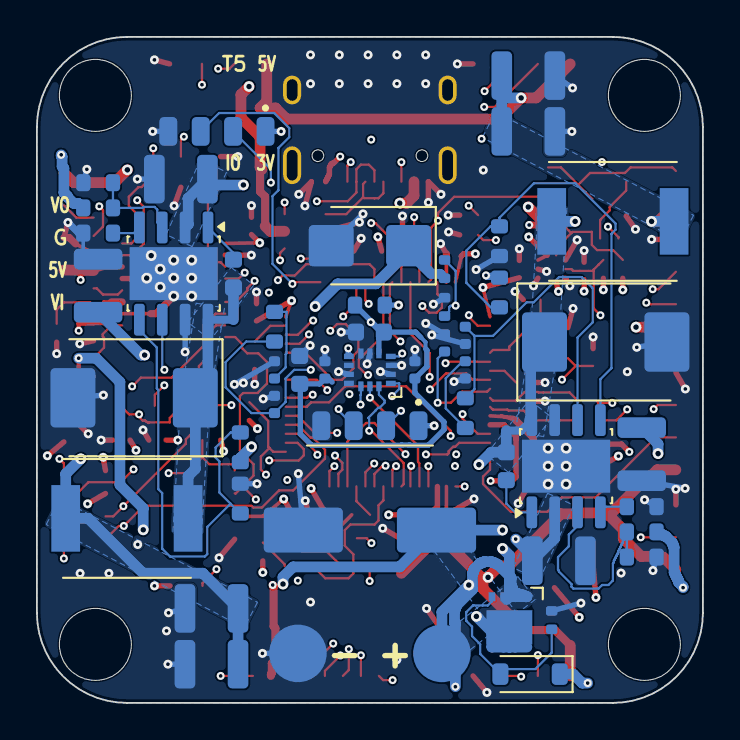
[picture p14: board fc_f405.kicad_pcb from below]

Board: 6 copper layers, 37.0 x 37.0 mm, 122 parts (49 on the bottom side), 90 nets.
